carlin77/Telescope/3D_Printing/gear120.SLDPRT

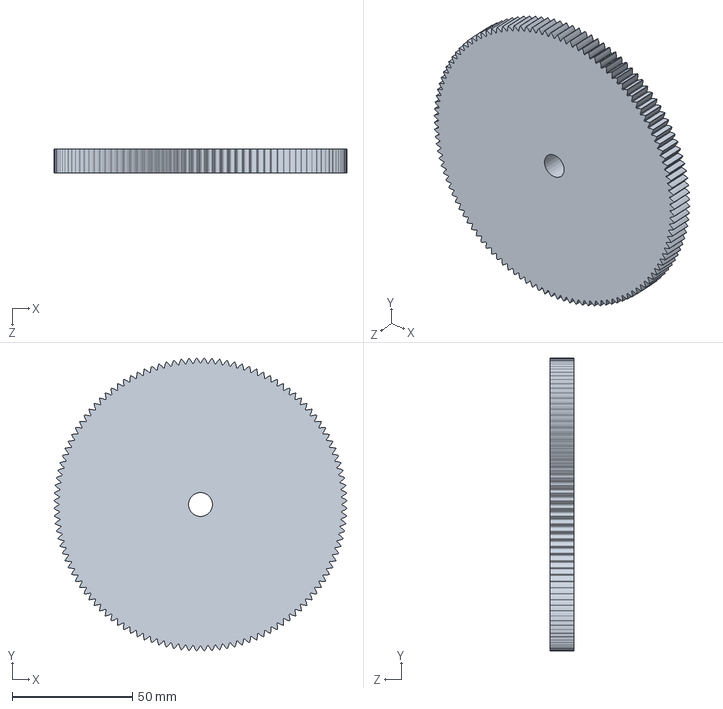
[picture p36: CAD file, 2024-12-12]
3D_Printing/gear120.SLDPRT
122.0 x 122.0 x 10.0 mm
