carlin77/Telescope/3D_Printing/bevel_gear.SLDPRT

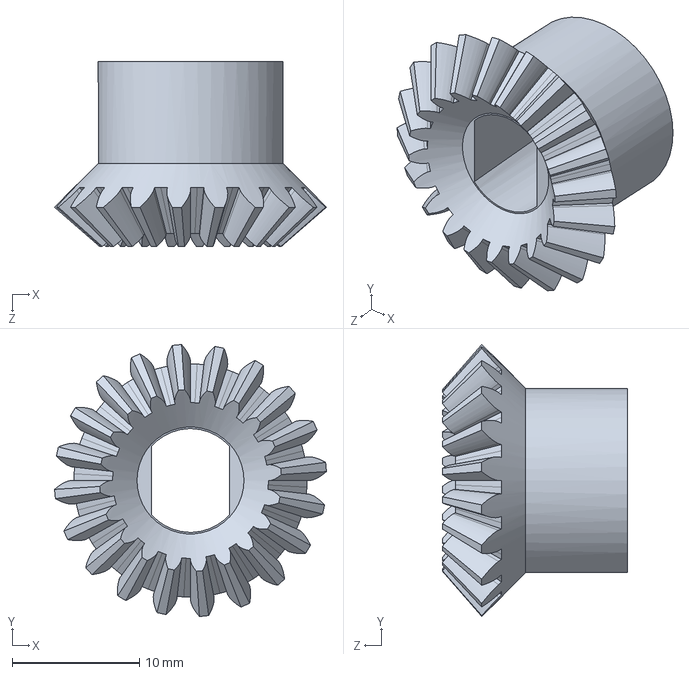
[picture p37: CAD file, 2024-12-12]
3D_Printing/bevel_gear.SLDPRT
21.4 x 21.4 x 14.5 mm
