carlin77/Telescope/3D_Printing/auxiliary_piece_1.SLDPRT

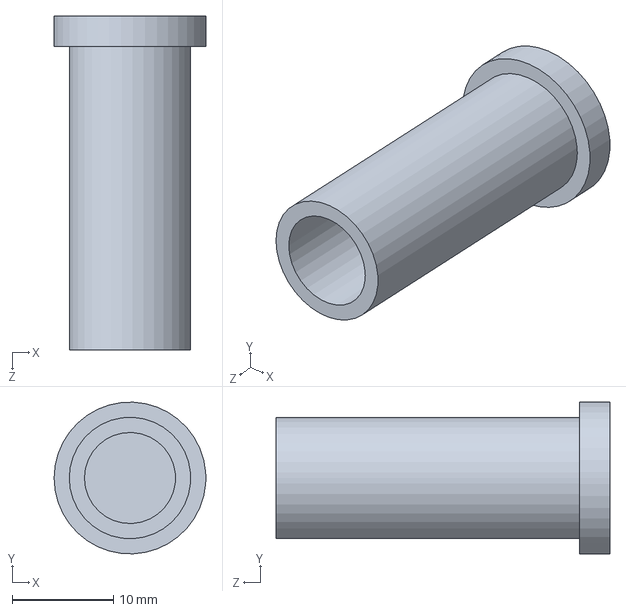
[picture p38: CAD file, 2024-12-12]
3D_Printing/auxiliary_piece_1.SLDPRT
15.0 x 15.0 x 33.0 mm
