carlin77/Telescope/3D_Printing/motor_support.SLDPRT

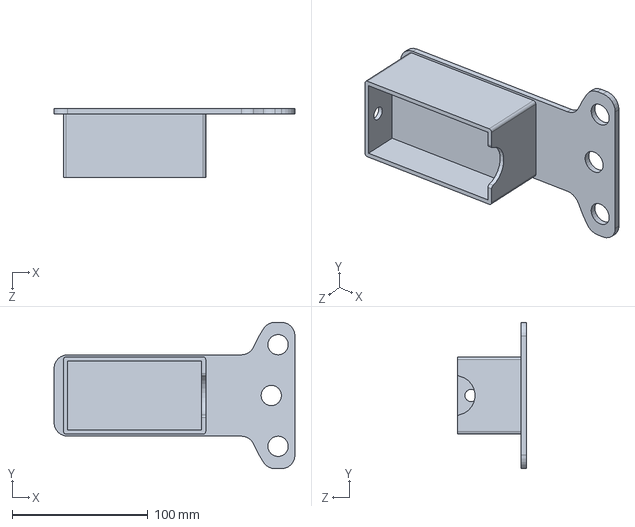
[picture p39: CAD file, 2024-12-12]
3D_Printing/motor_support.SLDPRT
177.9 x 108.0 x 51.0 mm
