carlin77/Telescope/3D_Printing/gear17.SLDPRT

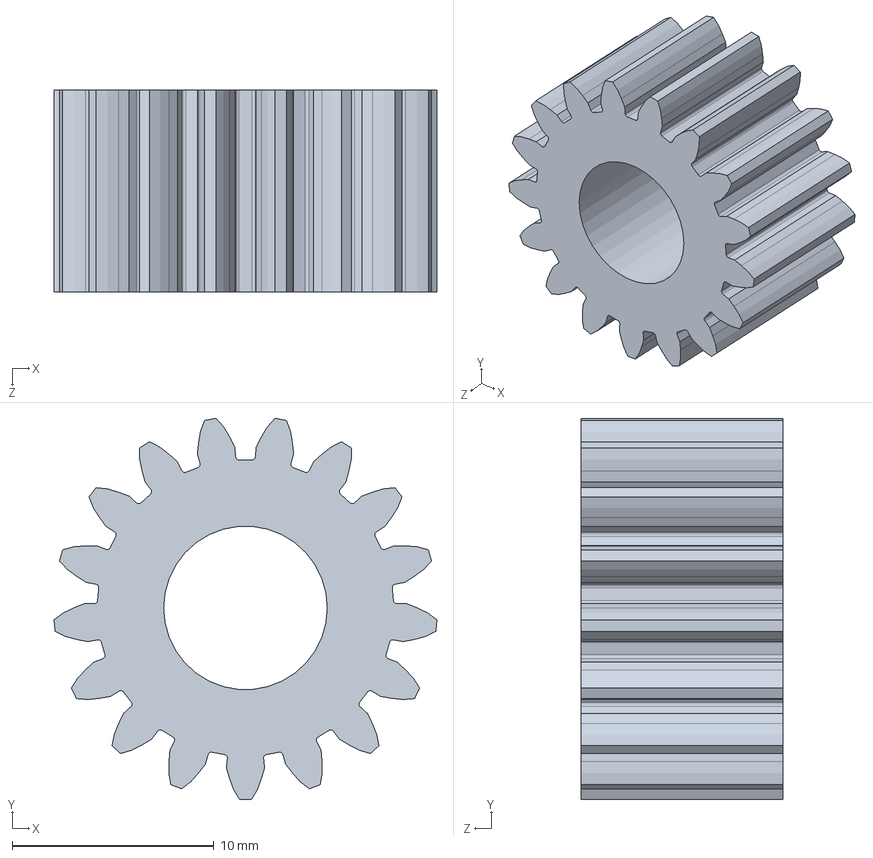
[picture p40: CAD file, 2024-12-12]
3D_Printing/gear17.SLDPRT
19.0 x 18.9 x 10.0 mm
