carlin77/Telescope/3D_Printing/coupler.SLDPRT

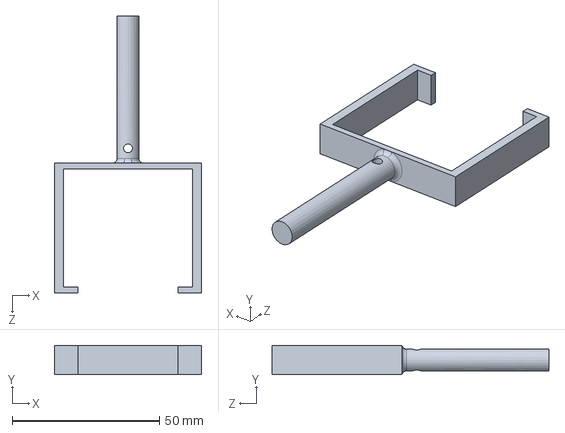
[picture p41: CAD file, 2024-12-12]
3D_Printing/coupler.SLDPRT
50.0 x 10.0 x 94.2 mm
