carlin77/Telescope/3D_Printing/Rpi_4_Case_Bottom.stl

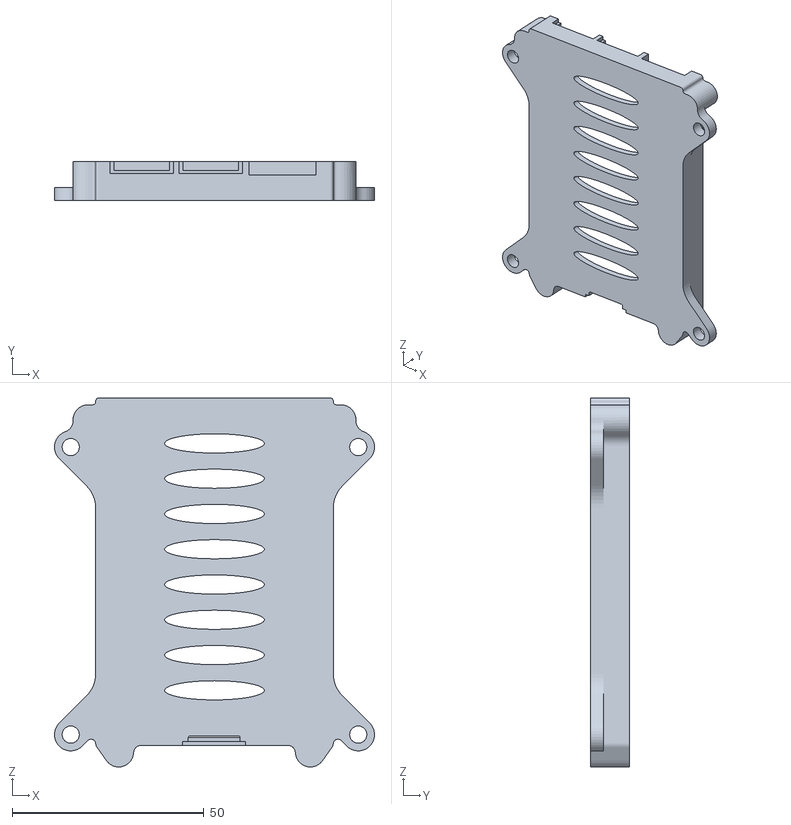
[picture p42: CAD file, 2024-12-12]
3D_Printing/Rpi_4_Case_Bottom.stl
83.5 x 10.3 x 96.2
