carlin77/Telescope/3D_Printing/height_compensator.SLDPRT

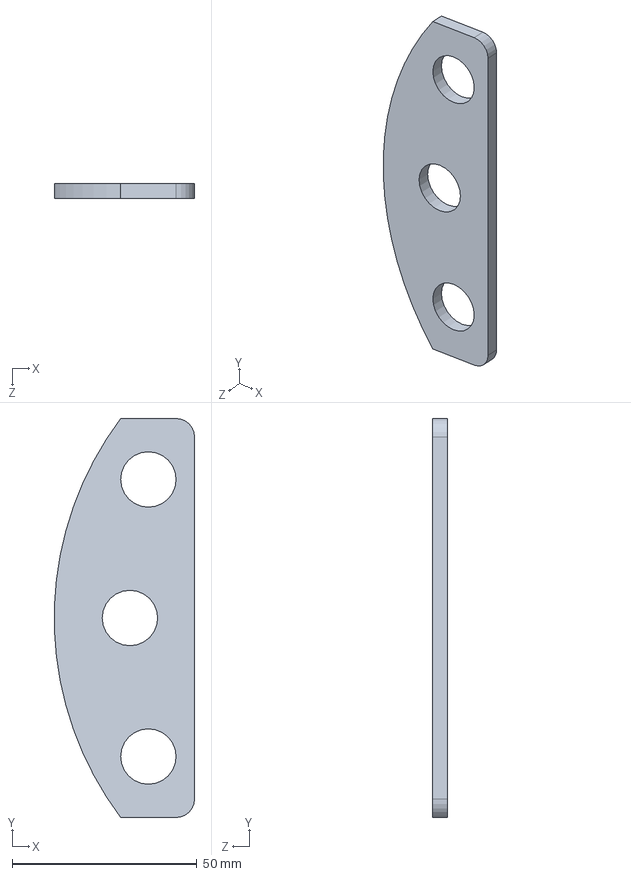
[picture p43: CAD file, 2024-12-12]
3D_Printing/height_compensator.SLDPRT
37.9 x 108.0 x 4.00 mm
