carlin77/Telescope/3D_Printing/auxiliary_piece_2.SLDPRT

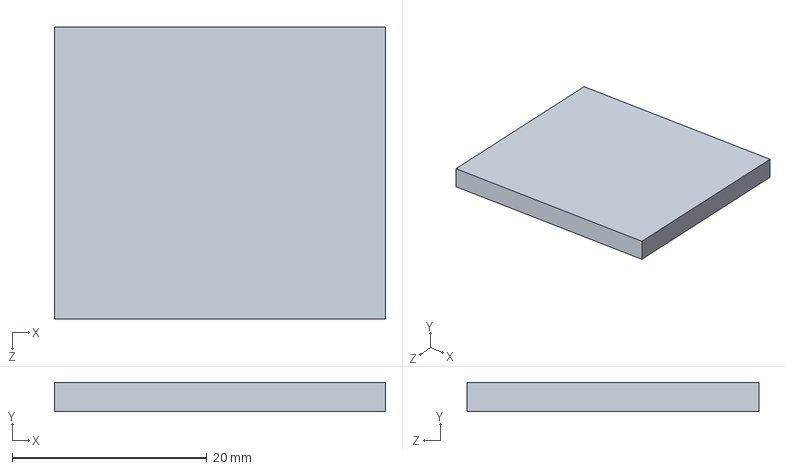
[picture p44: CAD file, 2024-12-12]
3D_Printing/auxiliary_piece_2.SLDPRT
34.0 x 3.00 x 30.0 mm
