carlin77/Telescope/3D_Printing/Rpi_4_Case_Top.stl

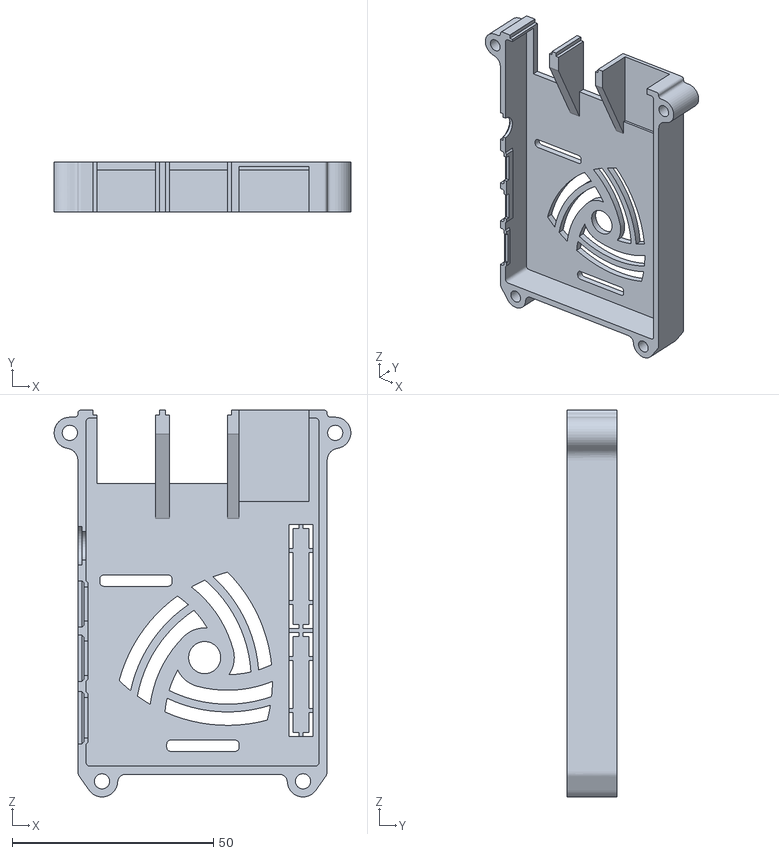
[picture p45: CAD file, 2024-12-12]
3D_Printing/Rpi_4_Case_Top.stl
73.8 x 12.5 x 96.2
