carlin77/Telescope/3D_Printing/shaft.SLDPRT

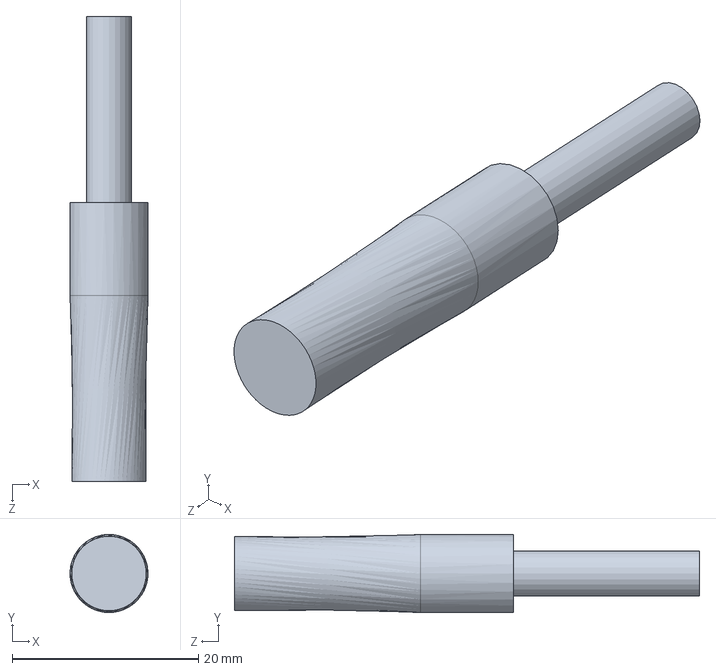
[picture p46: CAD file, 2024-12-12]
3D_Printing/shaft.SLDPRT
8.40 x 8.39 x 50.0 mm
